eike-welk/arduino_odometer/firmware/arduino-nano-quad-enc/README

################################################################################
                          Odometer for Donkeycar

                              Simple Pulse
################################################################################

This is a firmware for an odometer for a self driving toy car: the Donkeycar.

There are several different firmwares. This firmware:
* Written for the **Arduino Nano** based circuit board.
* Uses two **quadrature encoders (which contain two Hall sensors)** as inputs. It can therefore detect the
  direction of the rotation.
* Compiles with **Platform IO**.
