eike-welk/arduino_odometer/electronics/arduino-nano/export/odometer_bb.png

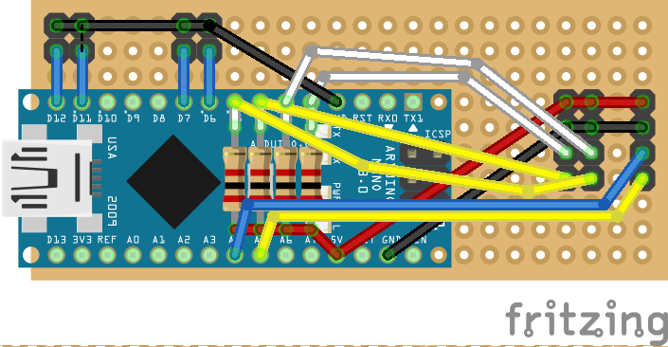
electronics/arduino-nano/export/odometer_bb.png
