eike-welk/arduino_odometer/electronics/arduino-nano/export/odometer_pcb.png

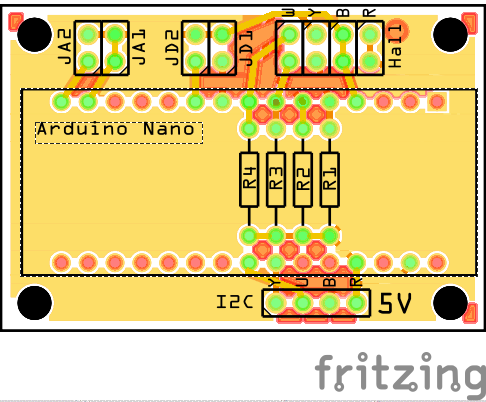
electronics/arduino-nano/export/odometer_pcb.png
