eike-welk/arduino_odometer/electronics/arduino-nano/export/odometer_schem.png

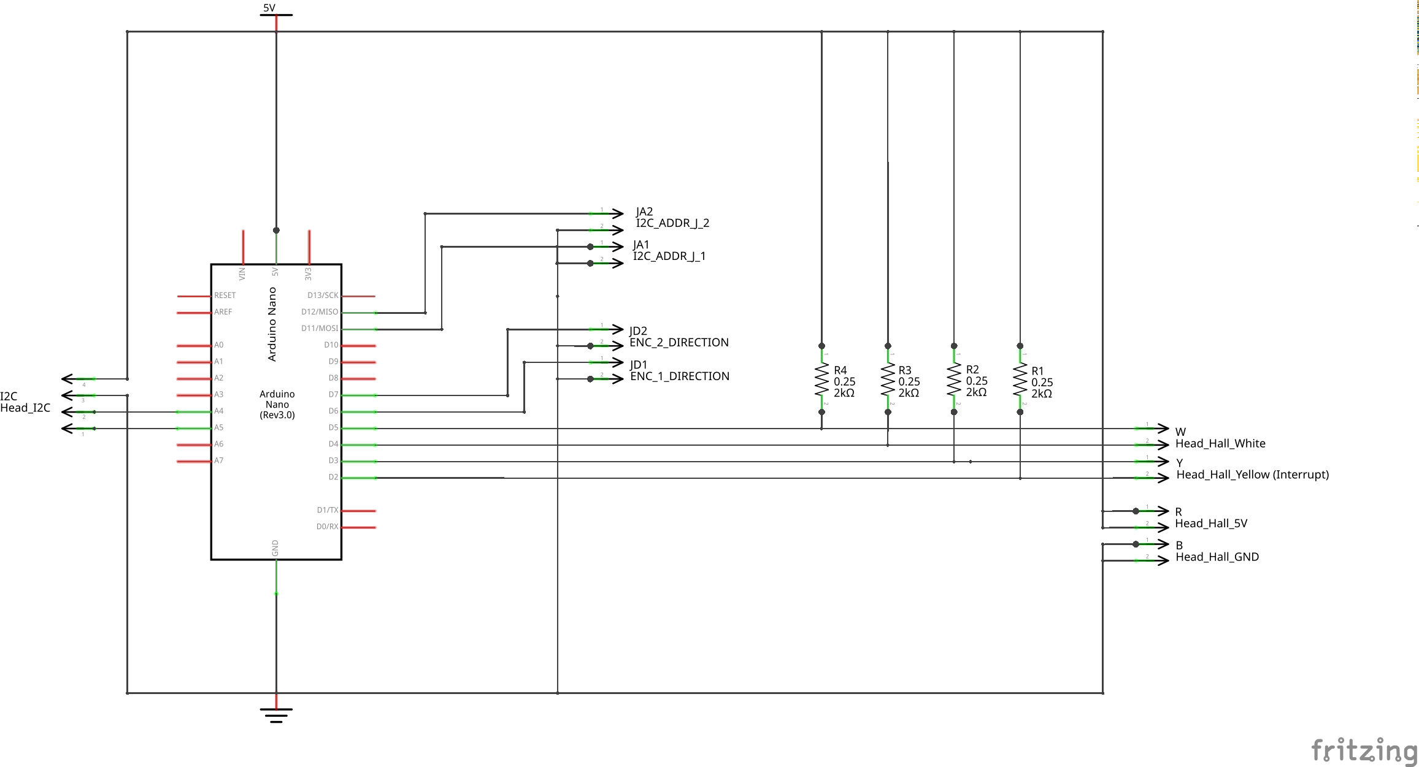
electronics/arduino-nano/export/odometer_schem.png
