eike-welk/arduino_odometer/mechanics/tamiya-tt-02/odometer-print-plate.3mf

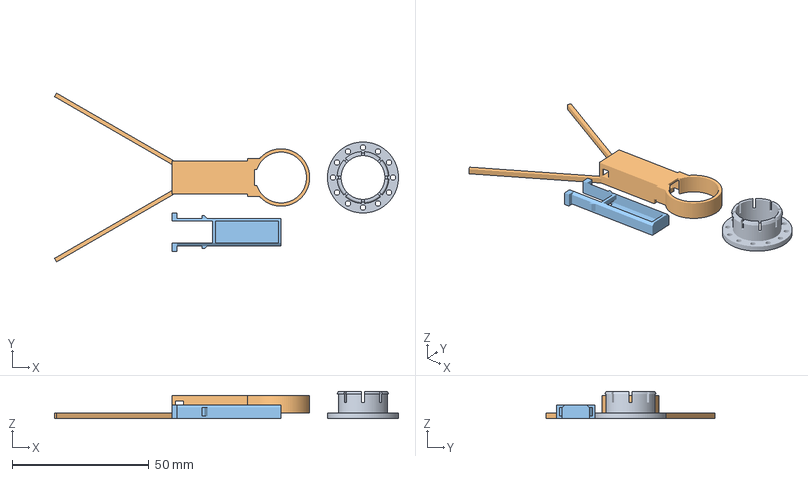
[picture p4: CAD file, 2021-02-15]
mechanics/tamiya-tt-02/odometer-print-plate.3mf
125.9 x 61.8 x 10.0 mm
odometer-print-plate.stl_1
odometer-print-plate.stl_2
odometer-print-plate.stl_3
