eike-welk/arduino_odometer/electronics/arduino-nano/export/odometer_etch_copper_bottom.pdf

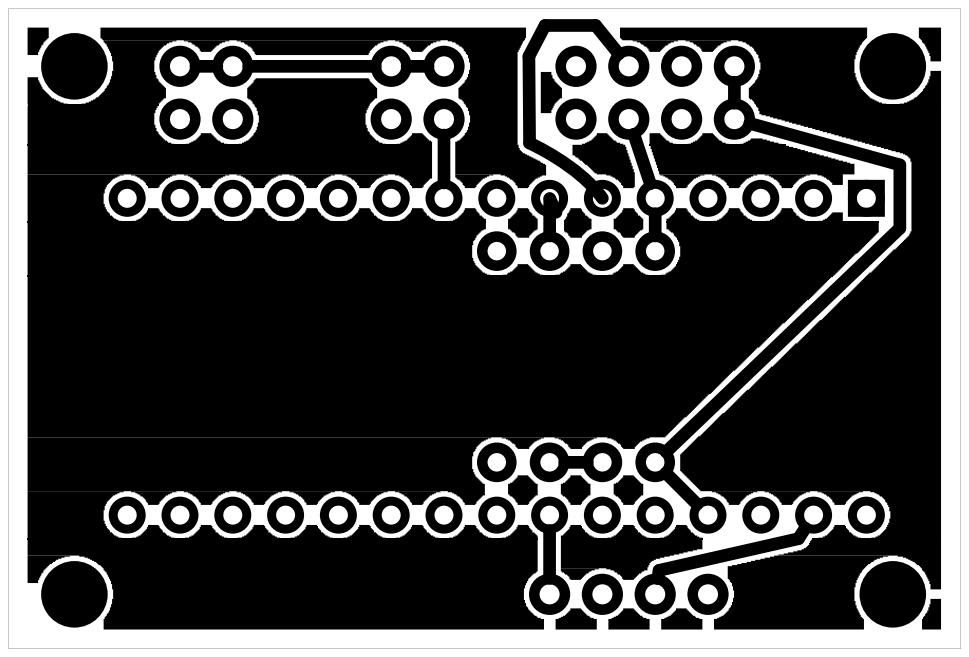
[picture p5: page 1]
