eike-welk/arduino_odometer/electronics/arduino-nano/export/odometer_etch_copper_bottom_mirror.pdf

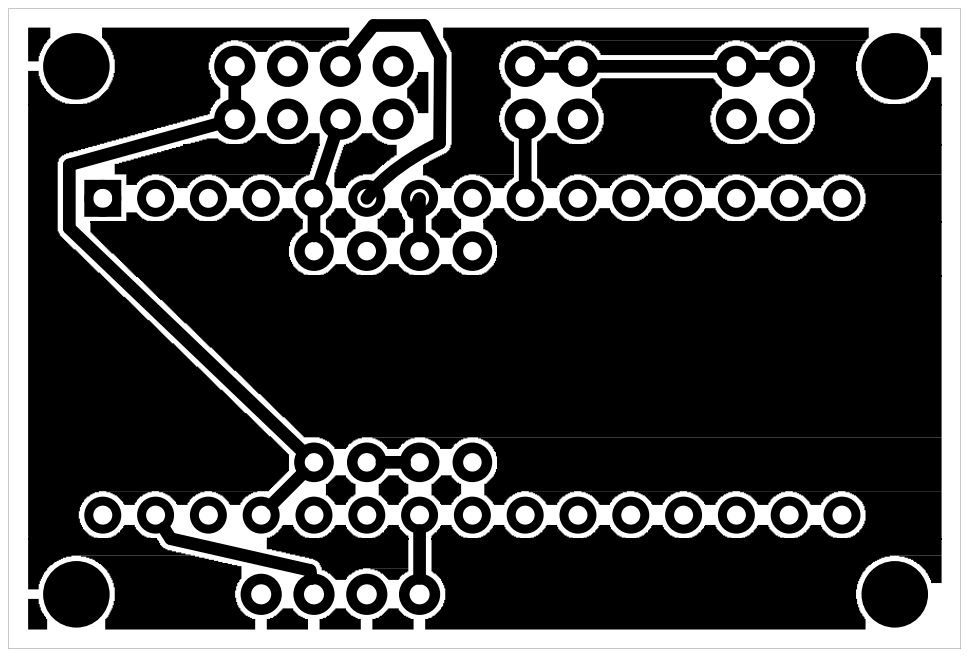
[picture p6: page 1]
