eike-welk/arduino_odometer/electronics/arduino-nano/export/odometer_etch_copper_top.pdf

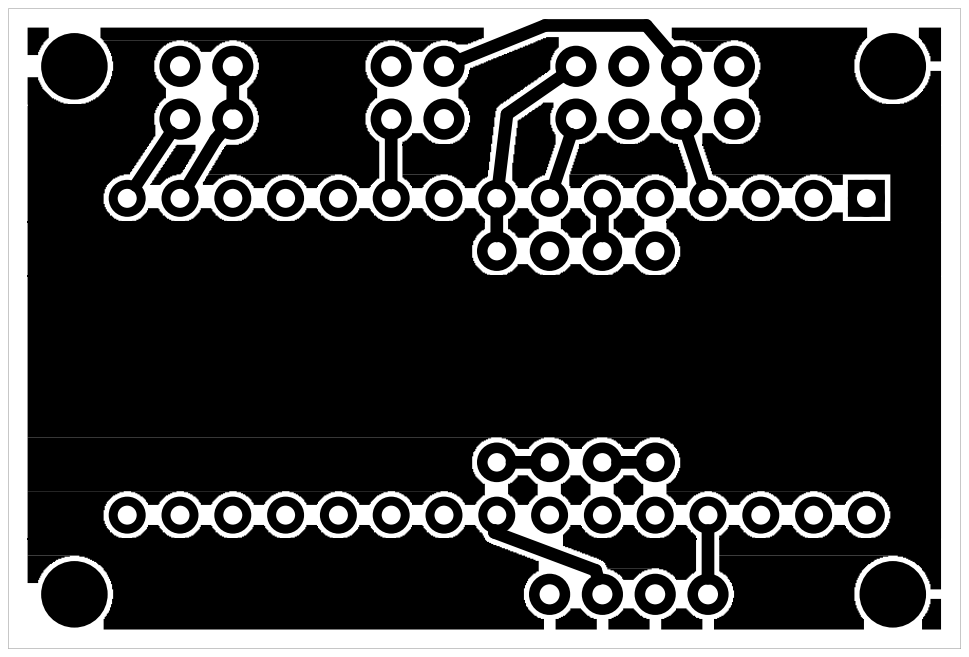
[picture p7: page 1]
