eike-welk/arduino_odometer/electronics/arduino-nano/export/odometer_etch_copper_top_mirror.pdf

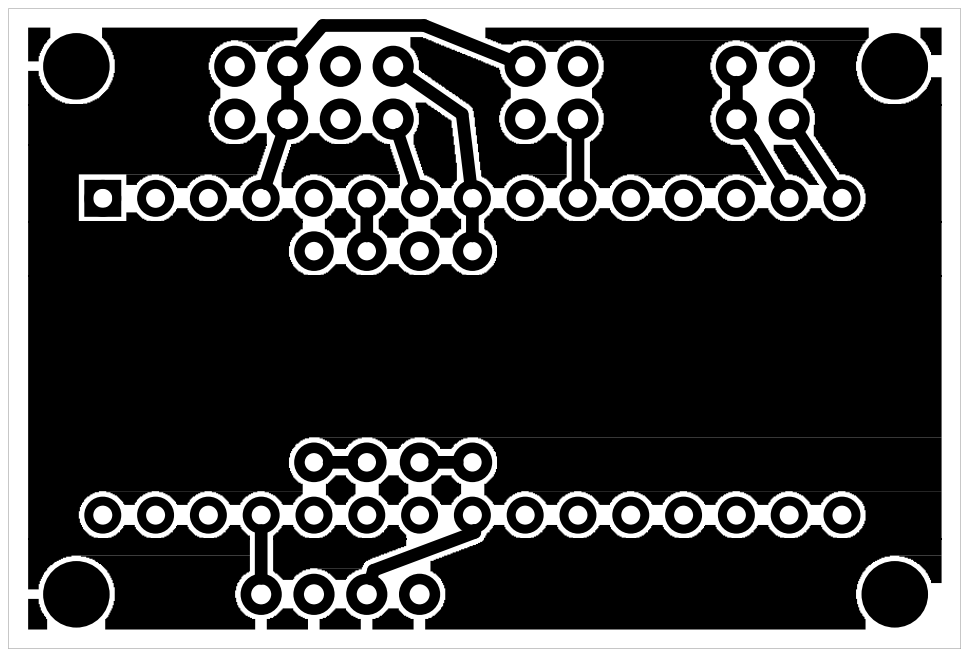
[picture p8: page 1]
