eike-welk/arduino_odometer/electronics/arduino-nano/export/odometer_etch_mask_bottom.pdf

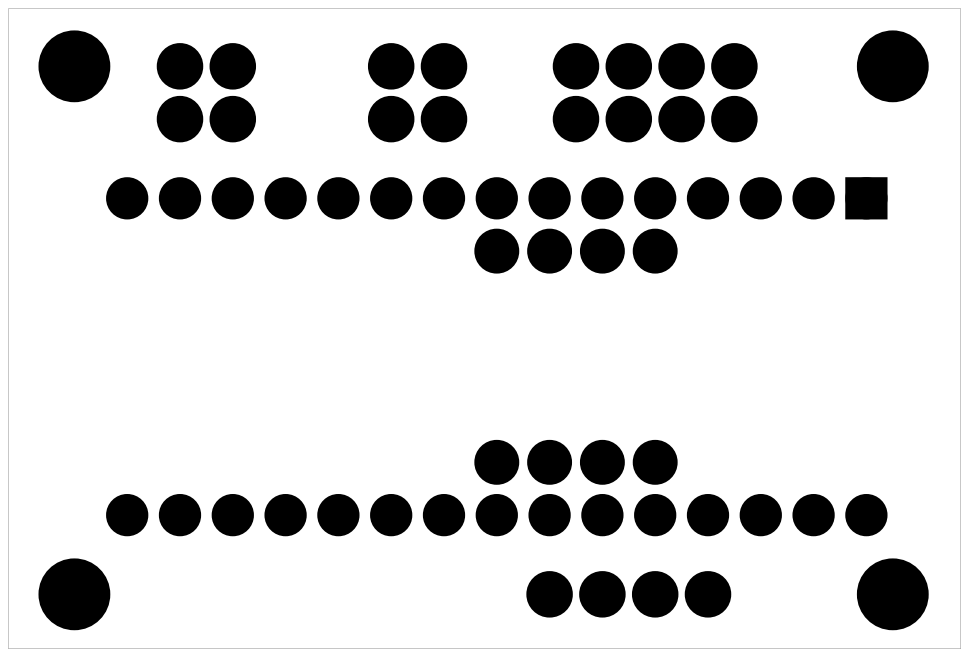
[picture p9: page 1]
