eike-welk/arduino_odometer/electronics/arduino-nano/export/odometer_etch_mask_bottom_mirror.pdf

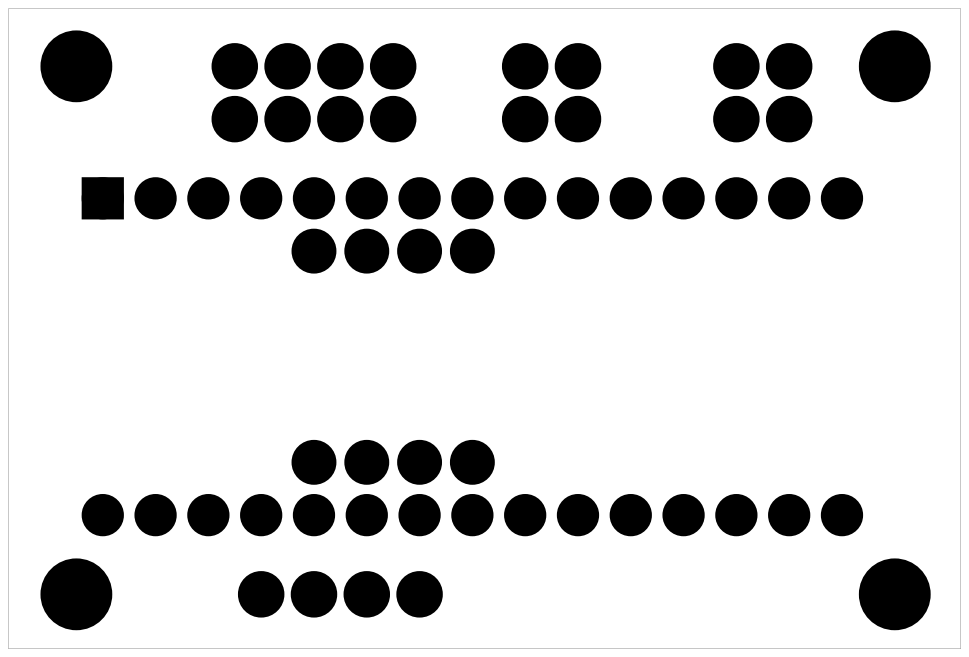
[picture p10: page 1]
