eike-welk/arduino_odometer/electronics/arduino-nano/export/odometer_etch_silk_bottom.pdf

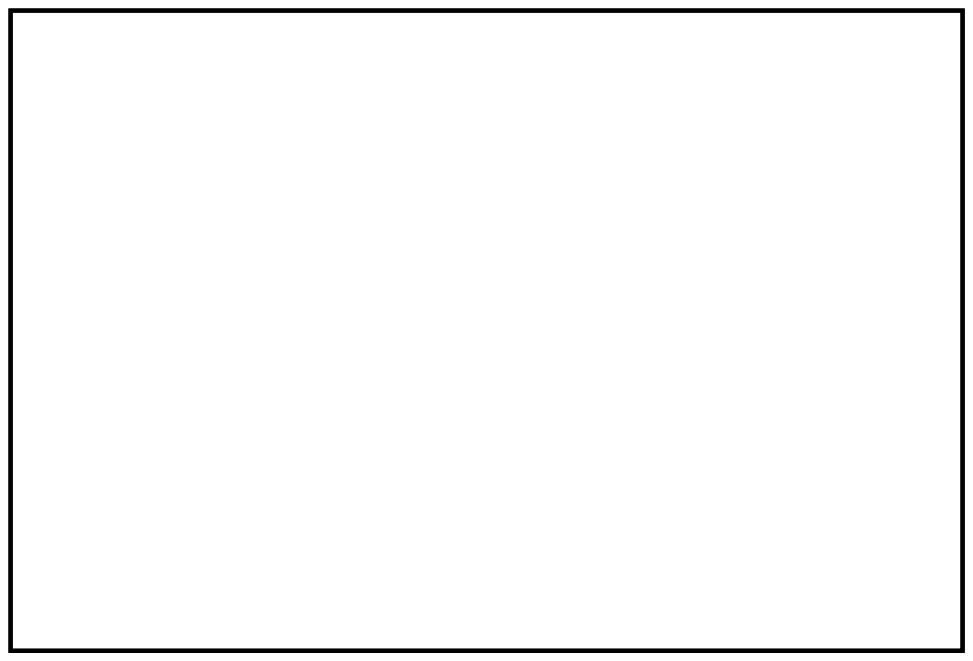
[picture p11: page 1]
