eike-welk/arduino_odometer/electronics/arduino-nano/export/odometer_etch_silk_bottom_mirror.pdf

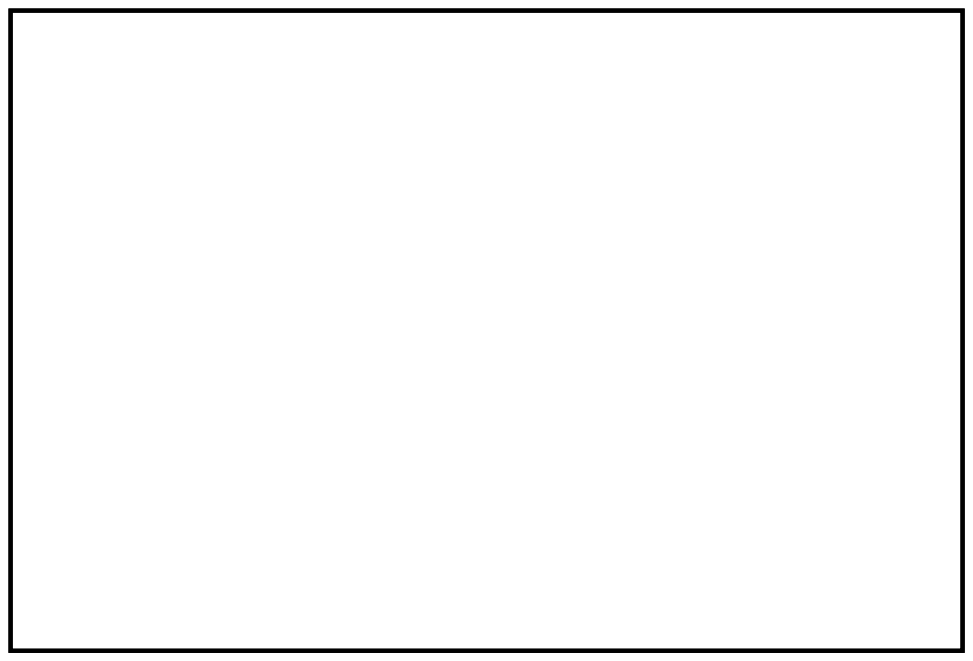
[picture p12: page 1]
