eike-welk/arduino_odometer/electronics/arduino-nano/export/odometer_etch_silk_top.pdf

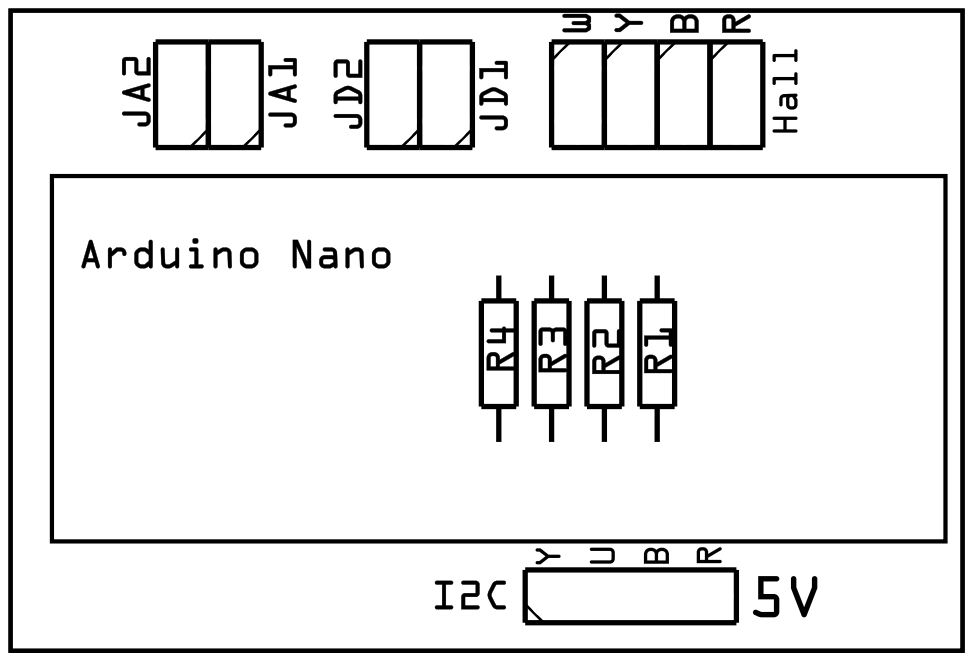
[picture p13: page 1]
