eike-welk/arduino_odometer/electronics/arduino-nano/export/odometer_etch_silk_top_mirror.pdf

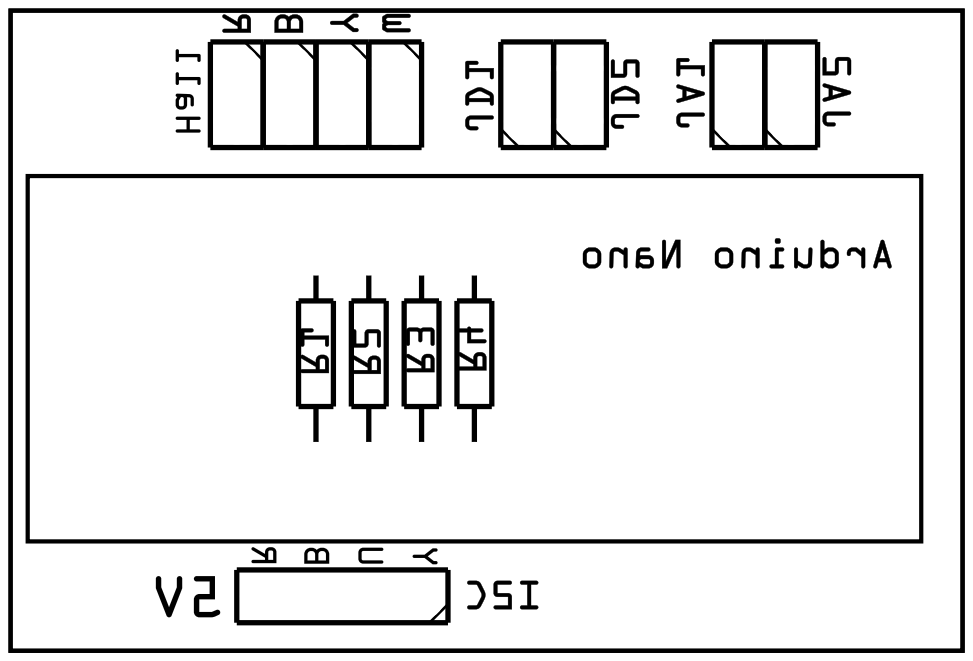
[picture p14: page 1]
