eike-welk/arduino_odometer/(list of files, drawings)

Other design files:
electronics/arduino-nano/odometer.fzz
