eike-welk/arduino_odometer/(commit log)

2019-03-09 Adding Arduino test files for the relevant technologies.
2019-03-09 Working Arduino code that needs testing and polishing.
2019-03-10 An activity LED works.
2019-03-12 Added rough Fritzing sketch.
    [odometer.fzz]
2019-03-13 Comment out the `Serial.print` calls.
    Without these debugging statements, there is much less waiting
    necessary on the I2C bus.
2019-03-15 Include "Encoder" library directly in the sources.
    The Arduino program is now self contained.
2019-03-16 Read quadrature encoder in main loop at full speed.
    Each encoder has only one interrupt. Calling `Encoder::read` reads the
    encoder pins, and updates the internal state.
    Also some code beautifications.
2019-03-16 Created useful schematics and production ready PCB.
    [odometer.fzz]
2021-02-07 Reorganized directories
    [odometer.fzz]
2021-02-07 Added documentation on magnetic sensors
2021-02-07 Added Scad script for mechanical parts
    [Body.scad, HallSensor.scad, Magnet.scad, MagnetHolderTool.scad, MagnetInsertionToolGrip.scad, MagnetInsertionToolTip.scad, MagnetWheel.scad, SensorInsert.scad]
2021-02-07 Updated now ignoring '*.stl'
2021-02-10 Added library for pin change interrupt
2021-02-10 Remove quadrature encoder library
2021-02-11 Interrupts work
2021-02-14 Implemented double buffered I2C
2021-02-14 LED binking is now controlled by calling `millis`
2021-02-16 Tweaked .gitignore so that Encoder library can be added to git
    This version of the Quadrature Encoder Firmware really compiles with
    Platform IO.
2021-02-16 Added test pulses to begin, end of I2C functions
2021-02-21 Directory for the Arduino firmware is now named "firmware"
2021-02-21 Added test firmware that generates pulses
    With this program an Arduino Nano on a breadboard can be used to test
    the odometer.
2021-03-04 New architecture without interrupts
2021-03-05 Swap values of right and left pins with a jumper
    [main.cpp]
2021-03-05 Numbering of the pulse connectors swapped
    The positions of the pulse connectors
    now match the positions of the RL pins.
    [main.cpp]
2021-03-12 Cleaned up Fritzing representations slightly, added /export
    As Fritzing is now somewhat hard to install the export directory is added
    to the repository. It should be possible to view the circuit without
    having Fritzing installed.
    [odometer.fzz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]
